he1ias/USB-rubber-ducky/README.md

# USB-rubber-ducky
A USB rubber ducky made for Hack Club's HalfLife event.

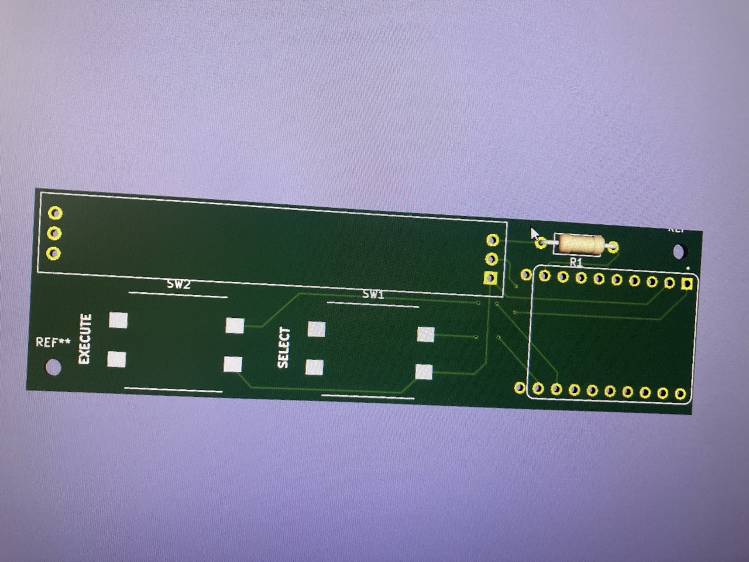
[picture p1: PCB.jpeg]
The finalised PCB


### What is a Rubber Ducky?

A Rubber Ducky is a toy hacking tool that can emulate USB keyboards, helping show the limits of what physical access to a device can achieve. 

### Why did you make it?

Because real Rubber Duckies, and other hacking devices like the Flipper Zero, are really expensive! I wanted to show just how powerful even a tiny microcontroller can be, and create something cheap and easy to use with it.

### What can it do?

It can play Snake, run commands on your computer at superhuman speeds, or just make you look like a hacker; among other things.

### How do I use it?

You'll first need to print the PCB and order all the parts (located in `BOM*.csv`, and shown below). Then, simply assemble, plug in the ESP32 and run the code located in `/Firmware`. The microcontroller will spin up its own web interface which can be accessed from your local network.

### What parts do I need?

Note all below prices are in AUD. This repository contains two different BOM.csv versions, one with the original AUD prices and one with the converted USD prices (1 AUD ~= 0.70 USD).

| Item | Description | Qty | Unit Price (AUD) | Line Total (AUD) | Link |
|---|---|-----|---|---|---|
| 1 | ESP32-S3-Zero Mini Development Board (4MB Flash, pre-soldered headers) | 1 | $10.60 | $10.60 | [Link](https://littlebirdelectronics.com.au/products/esp32-s3-mini-development-board-based-on-esp32-s3fh4r2-dual-core-processor-240mhz-running-frequency-2-4ghz-wi-fi-blueto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) |
| 2 | Female 10-pin header (PTH, 0.1") | 2 | $1.60 | $3.20 | [Link](https://littlebirdelectronics.com.au/products/header-10-pin-female-pth-0-1) |
| 3 | Little Bird Lorikeet WS2812B rainbow board (right angle header) | 1 | $3.50 | $3.50 | [Link](https://littlebirdelectronics.com.au/products/little-bird-lorikeet-ws2812b-rainbow-board-with-right-angle-header) |
| 4 | Tactile button (SMD, 12mm) | 2 | $1.65 | $3.30 | [Link](https://littlebirdelectronics.com.au/products/tactile-button-smd-12mm) |
| 5 | 470 ohm 0.5W metal film resistors (pack of 8) | 1 | $0.70 | $0.70 | [Link](https://littlebirdelectronics.com.au/products/470-ohm-0-5-watt-metal-film-resistors-pack-of-8) |
| 6 | OTG converter USB 3.0 to USB-C adapter | 1 | $2.40 | $2.40 | [Link](https://littlebirdelectronics.com.au/products/otg-converter-usb-3-0-convert-to-usb-c) |
| | **Total** | | | **$23.70** | |

### How was it made?

Using KiCad!

I first drew the schematic - this was pretty straightforward, all I had to do was connect up a few buttons, resistors, and a display to the ESP32:

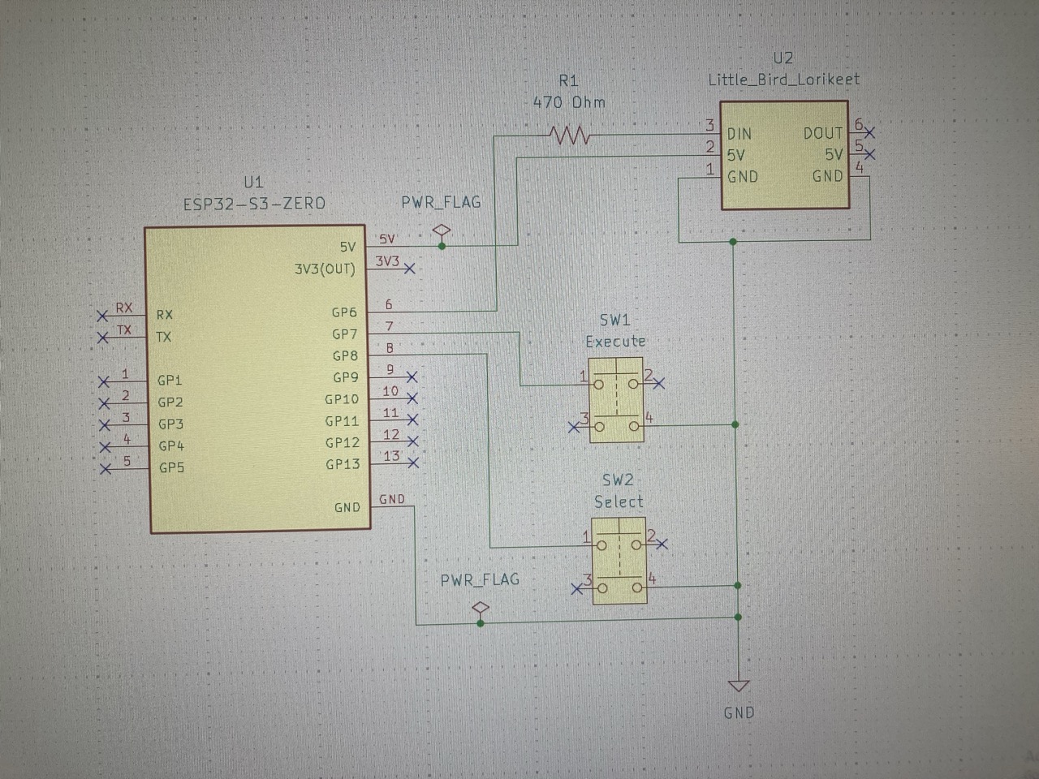
[picture p2: schematic.jpg]
The finalised schematic


...and then routed my PCB! I put a decent amount of effort into making sure the Ducky would be easy to use, and I think my finalised PCB found the right balance between simplicity and usability. The 5 LED display, for instance, can triple as a payload selector, progress indicator, and status light!

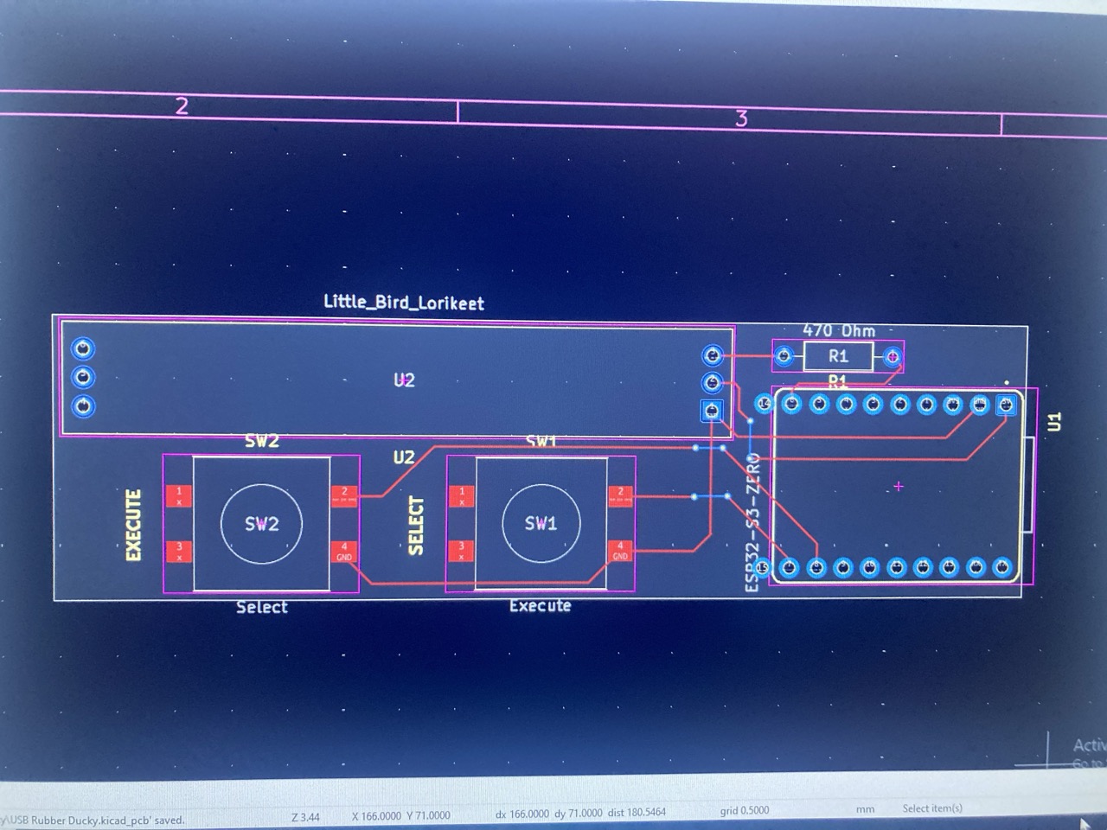
[picture p3: circuit.jpeg]
The finalised routing


Given this was my first PCB, I am happy with how it turned out! My full Half Life journal log can be found in `JOURNAL.md`.

Thanks for reading :)
