he1ias/USB-rubber-ducky/Keyboard/winning-snake.jpeg

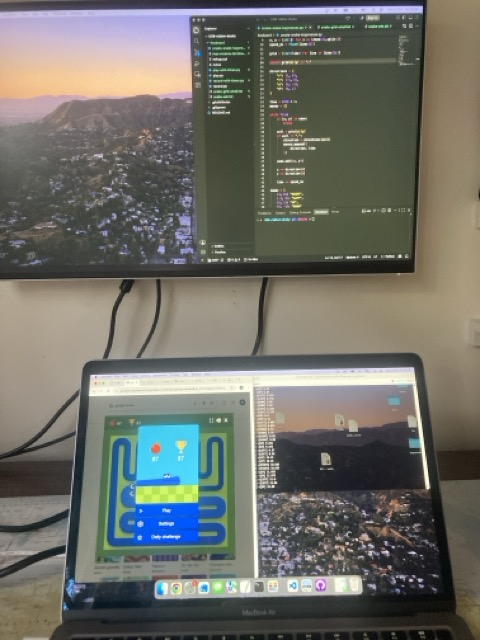
Keyboard/winning-snake.jpeg
