he1ias/USB-rubber-ducky/BOM.csv

Item | Qty | Supplier | Cost/item | Total Cost | link
ESP32-S3-Zero Mini Developement Board (4MB Flash, with Pre-soldered Headers) | 1 | Little Bird Electronics | $7.39 | $7.39 | https://littlebirdelectronics.com.au/products/esp32-s3-mini-development-board-based-on-esp32-s3fh4r2-dual-core-processor-240mhz-running-frequency-2-4ghz-wi-fi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
Button (12mm, SMD) | 2 | Little Bird Electronics | $1.15 | $2.30 | https://littlebirdelectronics.com.au/products/tactile-button-smd-12mm
470 Ohm Resistors - Pack of 8 | 1 | Little Bird Electronics | $0.49 | $0.49 | https://littlebirdelectronics.com.au/products/470-ohm-0-5-watt-metal-film-resistors-pack-of-8
Lorikeet LED Display | 1 | Little Bird Electronics | $2.44 | $2.44 | https://littlebirdelectronics.com.au/products/little-bird-lorikeet-ws2812b-rainbow-board-with-right-angle-header
Female 10-pin Headers | 2 | Little Bird Electronics | $1.12 | $2.24 | https://littlebirdelectronics.com.au/products/header-10-pin-female-pth-0-1
USB-C to USB-A Adapter | 1 | Little Bird Electronics | $1.67 | $1.67 | https://littlebirdelectronics.com.au/products/otg-converter-usb-3-0-convert-to-usb-c
NOTE: ALL PRICES HERE ARE LISTED IN USD, CONVERTED FROM AUD SHOWN ON VENDOR WEBSITE | 1 | - | $0.01 | $0.01 | https://example.com
Estimated total shipping | 1 |  |  | $10.00
