he1ias/USB-rubber-ducky/KiCad Project Files/USB Rubber Ducky.kicad_pcb

## KiCad design KiCad Project Files/USB Rubber Ducky.kicad_pcb (2026-10-11)

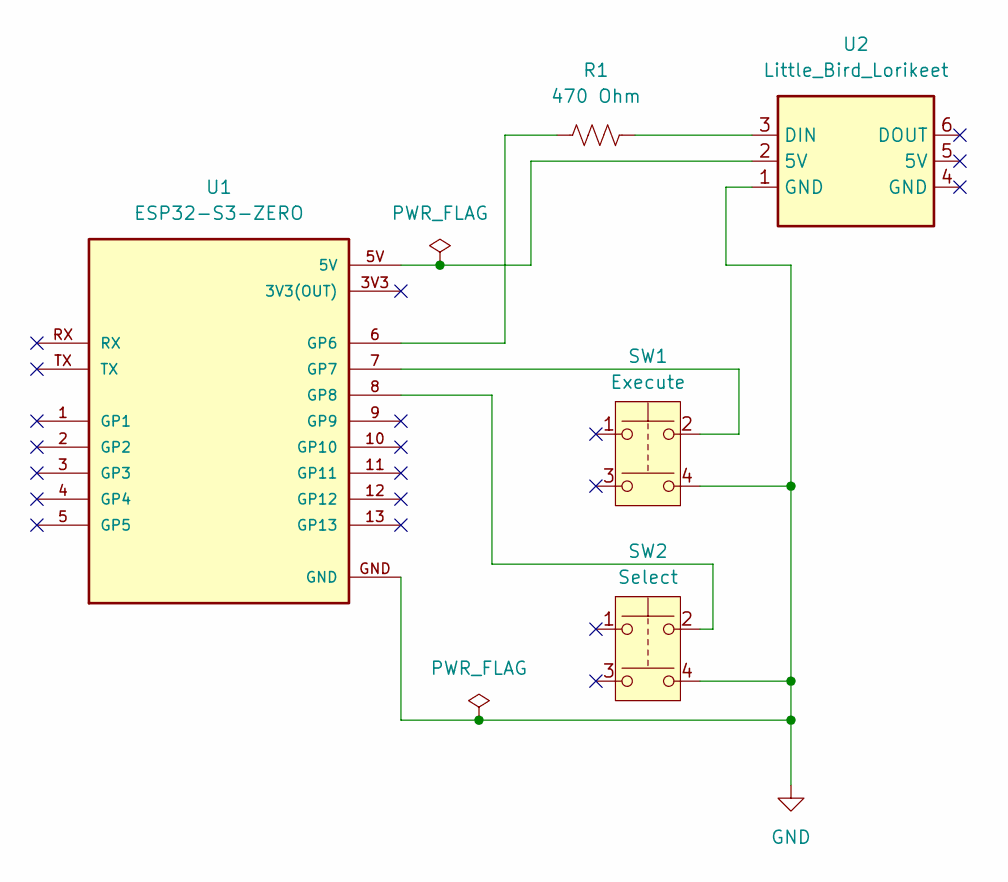
[picture p5: schematic USB Rubber Ducky.kicad_sch]

Parts:
R1: 470 Ohm; R_Axial_DIN0207_L6.3mm_D2.5mm_P10.16mm_Horizontal
SW1: Execute; SW_Push_12x12mm_TL3300
SW2: Select; SW_Push_12x12mm_TL3300
U1: ESP32-S3-ZERO; MODULE_ESP32-S3-ZERO_10PIN; PARTREV NA
U2: Little_Bird_Lorikeet

Connections:
GND: SW1.4, SW2.4, U1.GND, U2.1 (GND)
unnamed: R1.1, U1.6 (GP6)
unnamed: SW1.2, U1.7 (GP7)
unnamed: SW2.2, U1.8 (GP8)
unnamed: U1.5V, U2.2 (5V)
unnamed: R1.2, U2.3 (DIN)

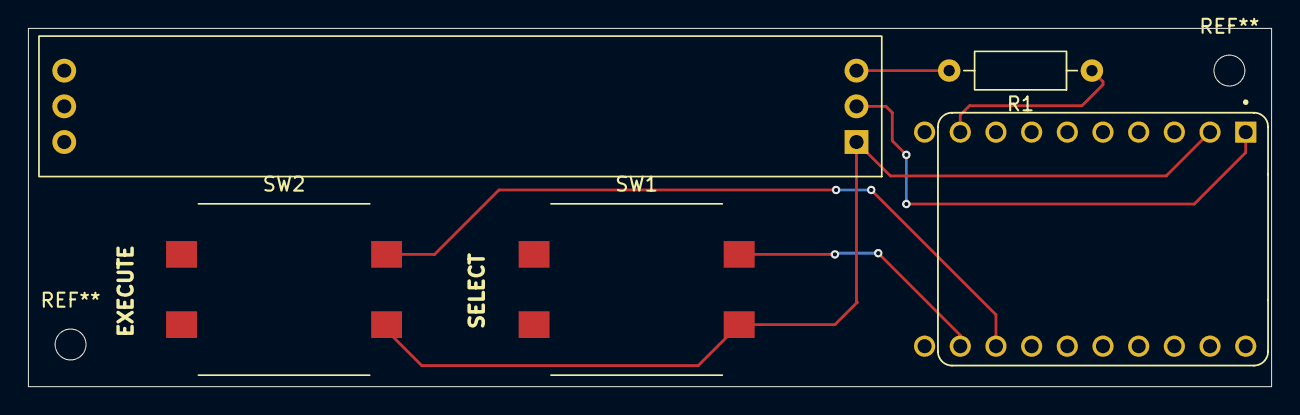
[picture p6: board USB Rubber Ducky.kicad_pcb from above]

Board: 2 copper layers, 88.5 x 25.5 mm, 5 parts (0 on the bottom side), 6 nets.
