he1ias/USB-rubber-ducky/Firmware/lorikeet-test.jpeg

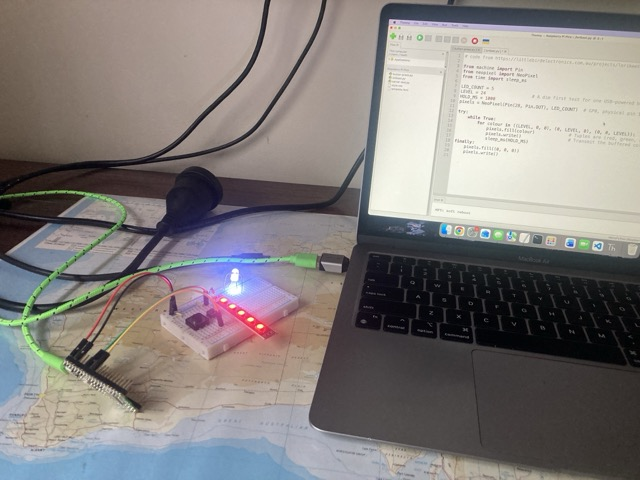
Firmware/lorikeet-test.jpeg
