he1ias/USB-rubber-ducky/Firmware/user-input-test.jpeg

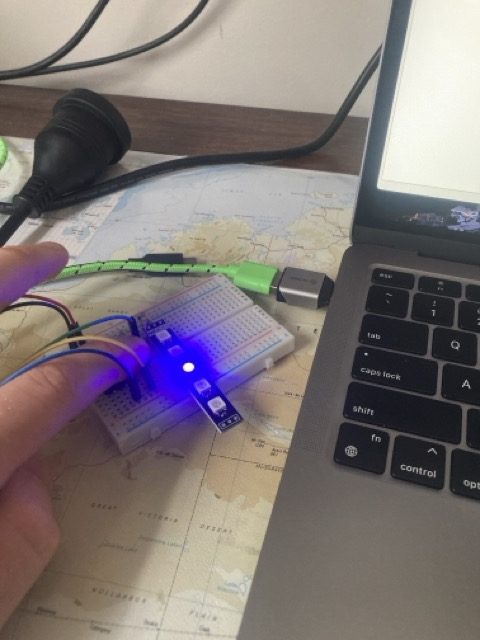
Firmware/user-input-test.jpeg
